oh7bf/RasPiHBridge/board_component.pdf

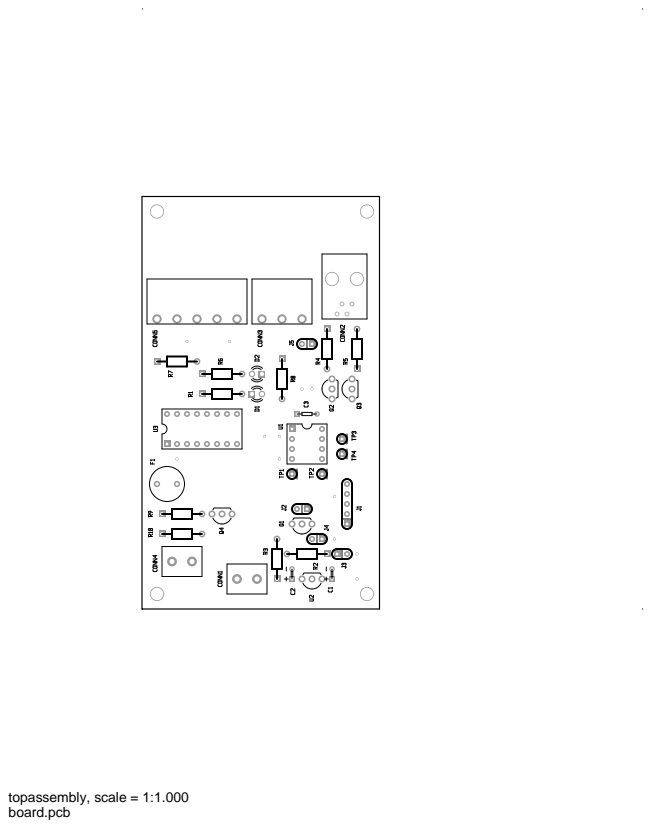
[picture p1: page 1]
board.pcb; topassembly, scale = 1:1.000
