oh7bf/RasPiHBridge/board_mirror.pdf

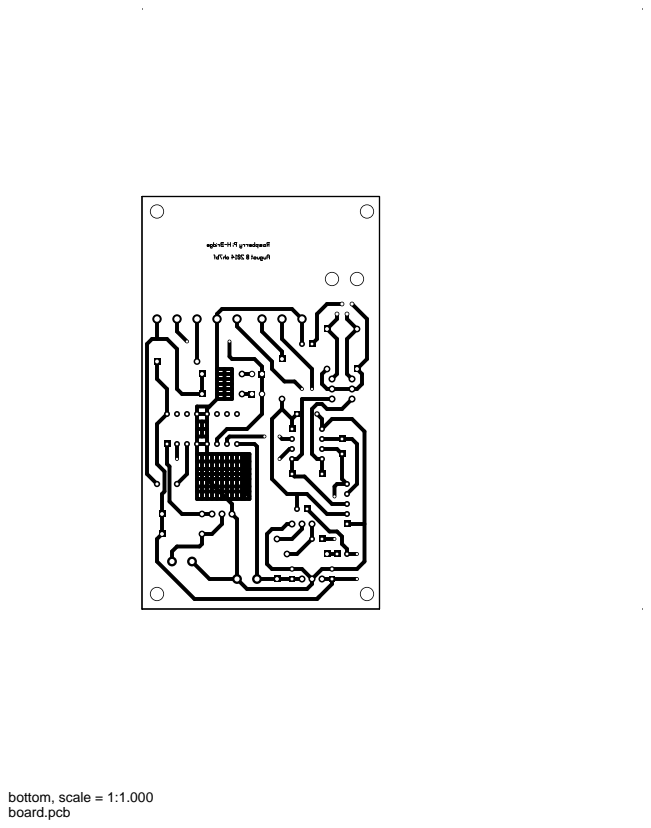
[picture p2: page 1]
board.pcb; bottom, scale = 1:1.000
