oh7bf/RasPiHBridge/board_silk_mirror.pdf

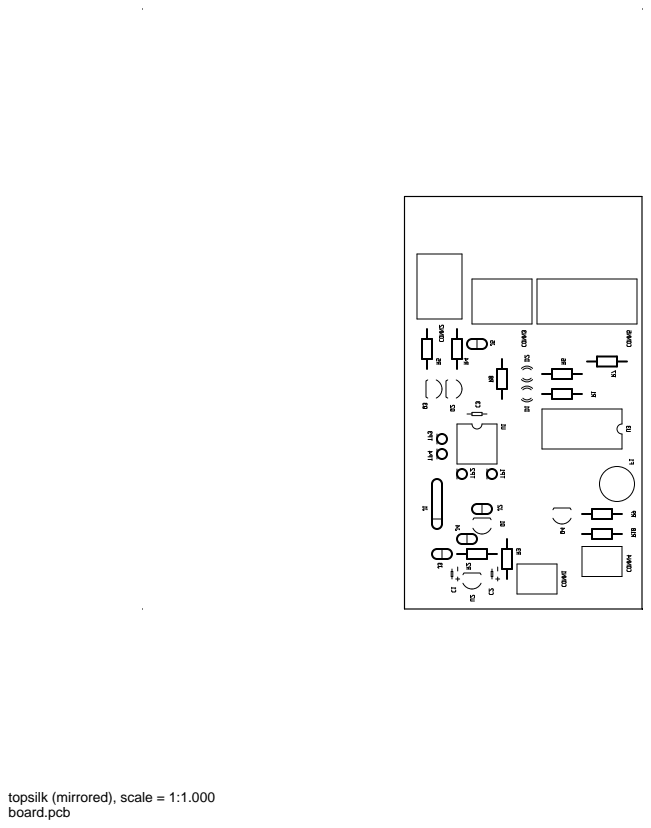
[picture p3: page 1]

topsilk (mirrored), scale = 1:1.000
board.pcb
