oh7bf/RasPiHBridge/raspihbridge.pdf

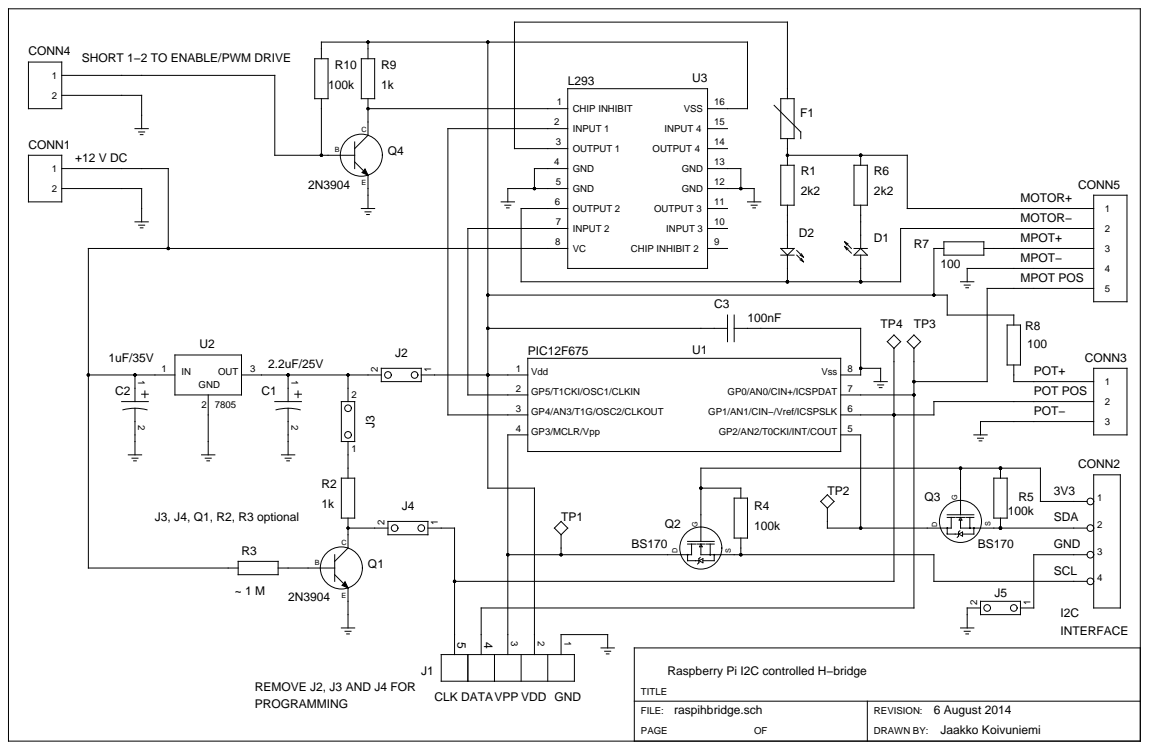
[picture p4: page 1]

Raspberry Pi I2C controlled H−bridge
