oh7bf/RasPiHBridge/(commit log)

2014-08-07 Add first version of circuit diagram.
    [raspihbridge.sch]
2014-08-08 Add printed circuit board for home production.
    See the README file for more details.
2014-08-08 Correction to i2c connection description.
    3V3 from Raspberry Pi is needed for level conversion FETs since PIC works
    from 5 V in this circuit.
2014-09-13 Change PiPIC clock cycle from 0.48 s to 0.06 s
    The T1CON register of pic12f675 can be used to set internal timer prescaler
    and to scale the implemented counter cycle.
